aclandmark/FP_display_for_UNO_V2/Design_doc.odt

_display_2 timing

Clock for the one wire link.

Synchronise 9.6K data stream to 16MHz CPU frequency.

UNO (328) Use timer zero with times 8 prescaler giving a 2MHz clock.

Counts to 208.

ATtiny 1606 also offers a times 8 prescaler

Timing

Set WPU on com port

Set slow clock tick rate AND call Display_driver(0);

Tick 1 call Display_driver(1);

Tick 2 call Display_driver(2);

Tick 3 call Display_driver(3);

Tick 7 call Display_driver(7); AND set fast clock tick rate and issue start bit

Tick 8 send bit 0

Tick 9 send bit 1

Tick 15 send bit 7

Ticks 16 – 24 receive start bit and 8 data bits and wait 0.5 clock cycle then WPU

Repeat with slow clock tick AND Display_driver(0);

Display/comms timing

1606: 16MHz clock 8MHz prescaler gives 2MHz peripheral clock

In a 2mS display period it counts to 4000.

4800 417 2ms

For a 9600 baud rate it counts to 208 Transaction time is 1ms

19200 104 0.52

28800 69 0.35

38400 52 0.26

328: 16MHz clock Use x8 or x64 prescalers giving 2MHz or 0.25MHz clocks.

For a 4800 baud rate it counts to 417 or 52 (0.25MHz clock)

9600 208 or 26

Experimental set up:

328 has a 0.25MHz timer clock and counts to 20 giving a baud rate of 12.5K

1606 has a 0.25MHz timer clock and counts to 28 Experimental value; (0.35MHz clock 22.4MHz free running clock??)

1606 0.5 second period 2MHz Peripheral clock x64 prescaler gives 31.25KHz clock which counts to 15625 in 0.5 s

(Note counting to 21875 gives a 0.5 second period.

Prescaler clock is 43.75KHz rather than 31.25KHz

Peripheral clock is 2.8MHz rather than 2MHz.)

assumes a clock of 43.75Hz 22.4MHz)

9600 Baud rate 1606 has peripheral clock of 2.8MHz Count to 292 rather than 202
