aclandmark/FP_display_for_UNO_V2/Manufacturung_drawings/FP_display_V2.brd

## EAGLE design Manufacturung_drawings/FP_display_V2.brd (2022-12-22)

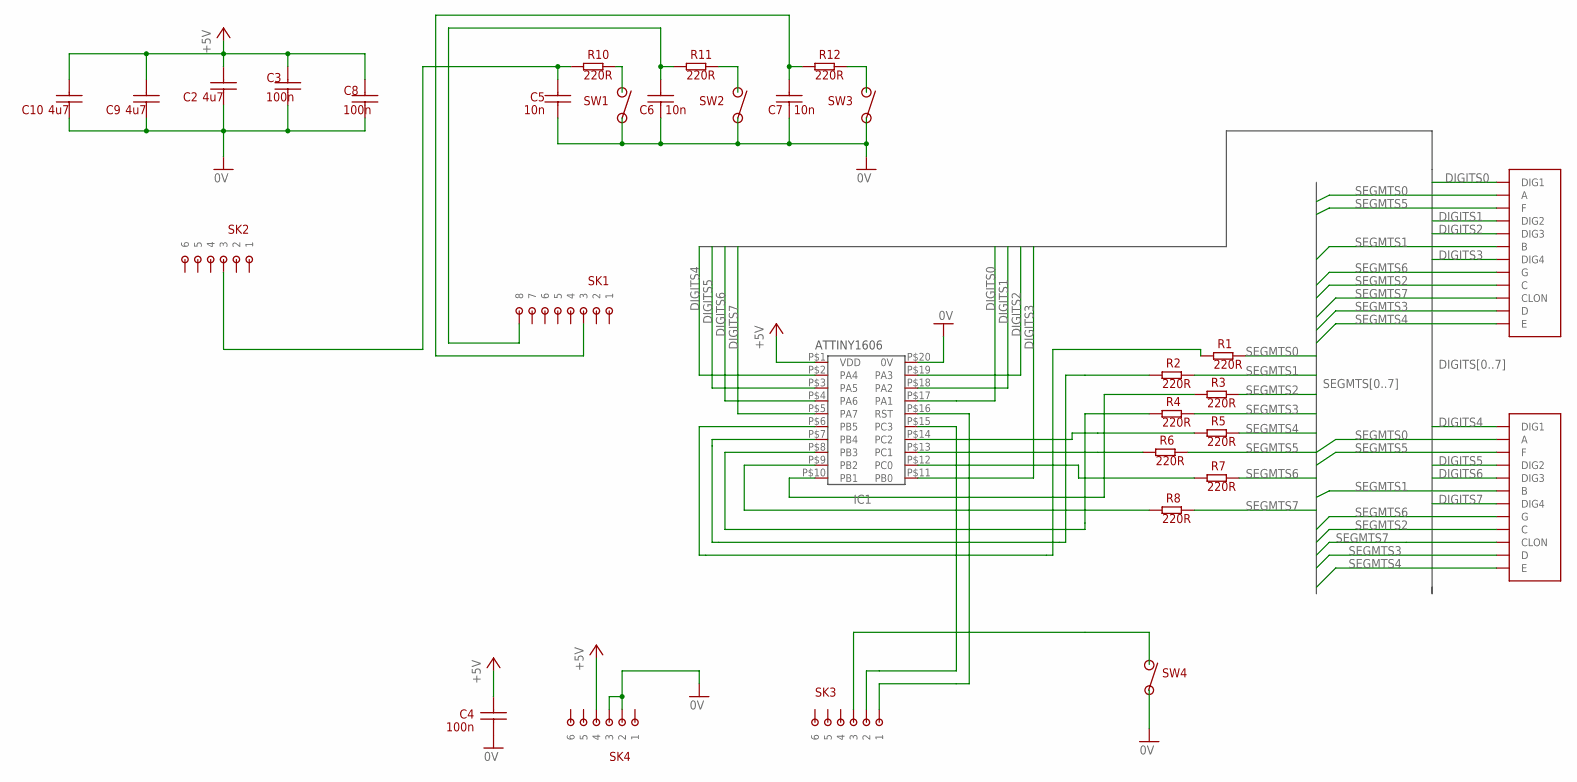
[picture p1: schematic FP_display_V2.sch]

Parts:
C2, C9, C10: 4u7; 1206
C3, C4, C8: 100n; 1206
C5, C6, C7: 10n; 1206
IC1: ATTINY1606
R1, R2, R3, R4, R5, R6, R7, R8, R10, R11, R12: 220R; 1206
SK1: 8_WAY_HEADER
SK2, SK3, SK4: 6_WAY_HEADER
SW1, SW2, SW3: BP_TH_NO; PB_NO_TH
SW4: PUSH_BUTTON_NO_SM
U$3, U$4: DISPLAY

Connections:
0V: C2.P$1, C3.P$1, C4.P$1, C5.P$1, C6.P$1, C7.P$1, C8.P$1, C9.P$1, C10.P$1, IC1.P$20 (0V), SK4.P$2 (2), SK4.P$3 (3), SW1.P$2, SW2.P$2, SW3.P$2, SW4.P$2
+5V: C2.P$2, C3.P$2, C4.P$2, C8.P$2, C9.P$2, C10.P$2, IC1.P$1 (VDD), SK4.P$4 (4)
DIGITS0: IC1.P$17 (PA1), U$3.P$12 (DIG1)
DIGITS1: IC1.P$18 (PA2), U$3.P$9 (DIG2)
DIGITS2: IC1.P$19 (PA3), U$3.P$8 (DIG3)
DIGITS3: IC1.P$11 (PB0), U$3.P$6 (DIG4)
DIGITS4: IC1.P$2 (PA4), U$4.P$12 (DIG1)
DIGITS5: IC1.P$3 (PA5), U$4.P$9 (DIG2)
DIGITS6: IC1.P$4 (PA6), U$4.P$8 (DIG3)
DIGITS7: IC1.P$5 (PA7), U$4.P$6 (DIG4)
unnamed: IC1.P$16 (RST), SK3.P$1 (1)
unnamed: IC1.P$6 (PB5), R1.P$1 (1)
unnamed: SK3.P$3 (3), SW4.P$1
unnamed: IC1.P$7 (PB4), R2.P$1 (1)
unnamed: IC1.P$15 (PC3), SK3.P$2 (2)
unnamed: IC1.P$12 (PC0), R7.P$1 (1)
unnamed: IC1.P$14 (PC2), R5.P$1 (1)
unnamed: IC1.P$13 (PC1), R6.P$1 (1)
unnamed: IC1.P$8 (PB3), R4.P$1 (1)
unnamed: IC1.P$10 (PB1), R3.P$1 (1)
unnamed: R10.P$2 (2), SW1.P$1
unnamed: R11.P$2 (2), SW2.P$1
unnamed: R12.P$2 (2), SW3.P$1
unnamed: C7.P$2, R12.P$1 (1), SK1.P$3 (3)
unnamed: C5.P$2, R10.P$1 (1), SK2.P$3 (3)
unnamed: C6.P$2, R11.P$1 (1), SK1.P$8 (8)
unnamed: IC1.P$9 (PB2), R8.P$1 (1)
SEGMTS0: R1.P$2 (2), U$3.P$11 (A), U$4.P$11 (A)
SEGMTS1: R2.P$2 (2), U$3.P$7 (B), U$4.P$7 (B)
SEGMTS2: R3.P$2 (2), U$3.P$4 (C), U$4.P$4 (C)
SEGMTS3: R4.P$2 (2), U$3.P$2 (D), U$4.P$2 (D)
SEGMTS4: R5.P$2 (2), U$3.P$1 (E), U$4.P$1 (E)
SEGMTS5: R6.P$2 (2), U$3.P$10 (F), U$4.P$10 (F)
SEGMTS6: R7.P$2 (2), U$3.P$5 (G), U$4.P$5 (G)
SEGMTS7: R8.P$2 (2), U$3.P$3 (CLON), U$4.P$3 (CLON)

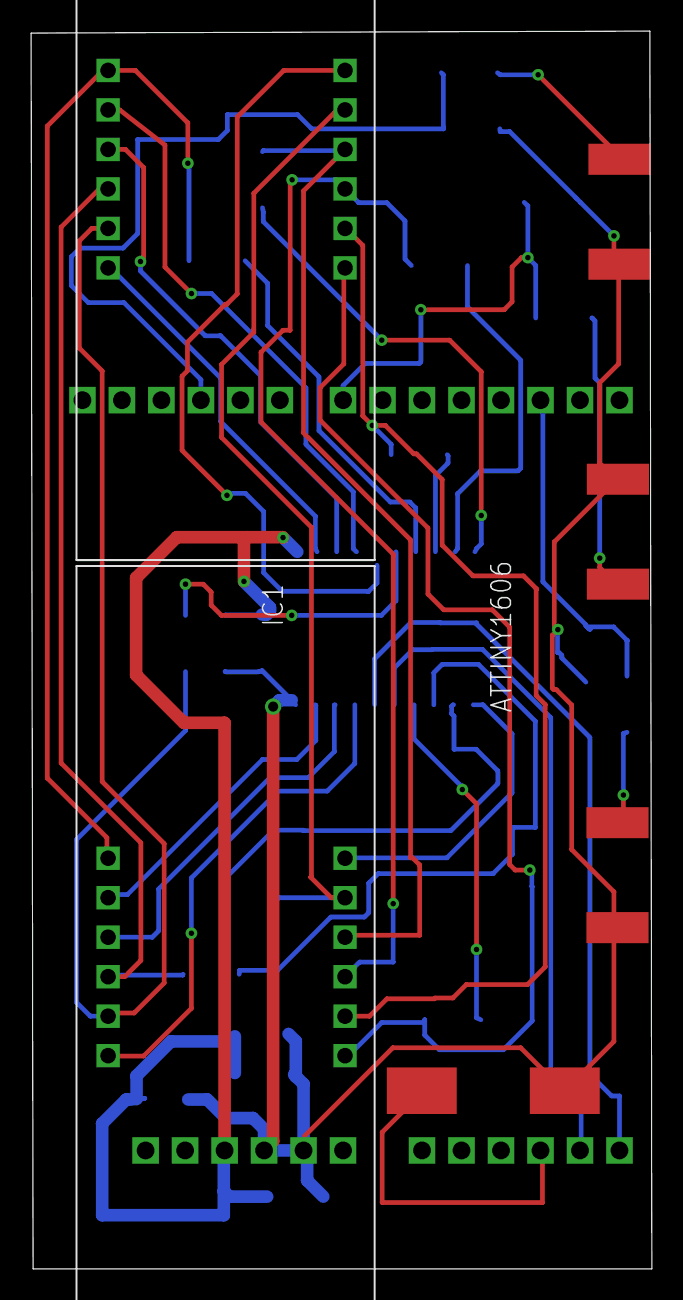
[picture p2: board FP_display_V2.brd from above]

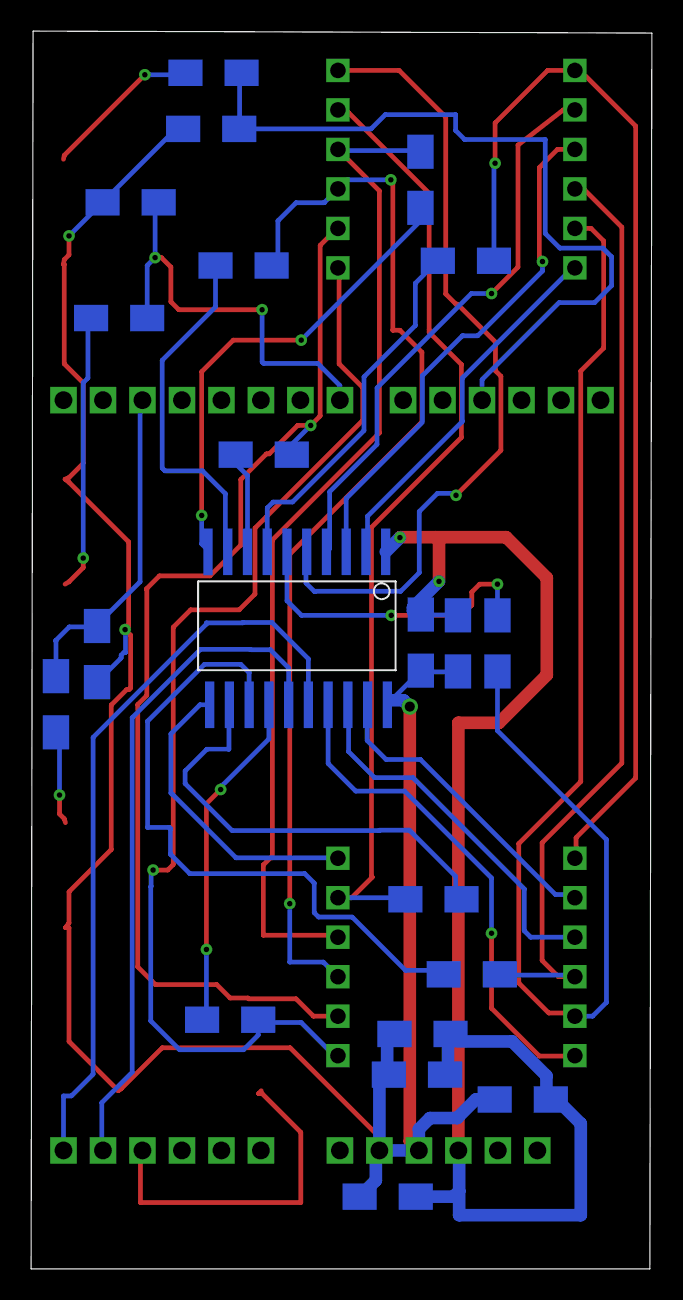
[picture p3: board FP_display_V2.brd from below]

Board: 2 copper layers, 39.9 x 79.6 mm, 31 parts (21 on the bottom side), 35 nets.
