aclandmark/FP_display_for_UNO_V2/Template_V9/Template_V9.ino

#include "Resources_Template_V9.h"                              //Contains resources used by template and shared with programmer
//#include "Resources_UPDI_programmer.h"                          //Only contains resources used by the programmer



/*
 * Programmer uses PC0 which is initialsed to Hi-Z input
 * Floating point display template uses PC4 for sinlge wire UART. It is also Hi-Z
 * All other ports are WPU
*/


int main (void){ 
  
char keypress;
long int_num;
float FPN;
char FP_string[12];


setup_328_HW;                                           //see "Resources\ATMEGA_Programmer


/************************Programmer code starts here and can be removed************************************
FlashSZ = 0x2000;                                      //Amount of flash availale in ATtiny 1606
User_prompt;

sendString("\r\nPress 'a' to program target or AOK to run taget code\r\n\r\n");
if(waitforkeypress() == 'a'){

//********************************Programmer target connection sequence************************************
Timer_T1_sub_with_interrupt(T1_delay_100ms);
sei();
contact_target;
configure_updi;                                       //Increases UPDI clock to 16MHz and reduce guard band to 2 cycles
print_out_SIB;
if(UPDI_timeout)
{sendString("Power Cycle Required\r\n");
while(1);}
else{cli();TCCR1B = 0;
TIMSK1 &= (~(1 << TOIE1));}

initialise_NVM_programming;
sendString("Programming fuses\r\n");
write_fuse (WDTCFG, 0x0);                             //Default value: WDT under program control
write_fuse (BODCFG,0x0);                              //Default value: BOD dissabled
write_fuse (OSCCFG, 0x01);                            //select the 16MHz internal clock with factory cal
write_fuse (SYSCFG0, 0xF7);                           //UPDI enabled, EEPROM preserved at chip erase
write_fuse (SYSCFG1, 0xFD);                           //16mS SUT
write_fuse (APPEND, 0);                               //No area of flash is partitioned off 
write_fuse (BOOTEND, 0);                              //for data or a bootloader


sendString("\r\nProgram flash with hex? -y- or AOK");
if (waitforkeypress() == 'y')
{ mode = 'H';                                         //Text mode is not included in this version of the programmer
sendString("\r\nSend file  ");
Program_Flash_Hex();}

Verify_Flash_Hex();
sendString("\r\nFuses:\tWDT, BOD, OSC,SYS0\tSYS1, APPEND, BOOTEND\r\n\t");
read_out_fuses();

UPDI_reset; 
Dissable_UPDI_sesion;}


//************Code for the UNO Floating point display is presented in the next section *************************
//**********************It is combined with the 1606 programmer for convenience**********************************
//*****************When development is complete the two applications can be separated***********************



sendString("\r\n\r\nRun trial application? -y- or AOK (POR may be required)\r\n\r\n");
if(waitforkeypress() == 'y'){

************************Programmmer code ends here*******************************************************************/


PCICR |= (1 << PCIE1); PCMSK1 |= (1 << PCINT11);                            //Set up PCI for SM switch
PORTC &= (~(1 << PORTC4));                                                  //One way comms for template requires port to be set to Tri state 
One_wire_Tx_char = 'F'; UART_Tx_1_wire();                                   //Command to reset 1606


while(1){

sei();                                                                      //Required to control intensity
  
User_prompt_template;

if (User_response =='i'){
sendString("Enter integer from KBD (terminate in cr)\r\n");

while (int_num = Int_from_KBD()){
sendString("AK to do arithmetic\r\n");
waitforkeypress();
Long_Num_to_UNO = Long_Num_from_UNO * 2;                                    //Simple arithmetic to check operation of binary/string conversions
send_int_num(Long_Num_to_UNO);
sendString("New number?\r\n");}}

if (User_response =='f'){
 sendString("Enter FPN from KBD (terminate in cr)\r\n"); 
 FPN =  Float_from_KBD();
 waitforkeypress();
 FPN = FPN * 2.75;                                                          //Simple arithmetic to check operation of binary/string conversions
send_float_num(FPN);}}

//}                                                                           //Only required if programmer code is included
/**********************************End to test code section*********************************************/
SW_reset;
return 1;}


 
