aclandmark/FP_display_for_UNO_V2/Template_V9/Resources_Template_V9.h

#include <avr/io.h>
#include <stdlib.h>
#include <avr/interrupt.h>
#include <avr/wdt.h>
#include <avr/eeprom.h>


#include "Resources_Template_V9\Resources_Template_V9.h"
#include "Resources_Template_V9\One_wire_transactions.c"
#include "Resources_Template_V9\ASKII_subroutines.c"
#include "Resources_Template_V9\Resources_shared.h"
#include "Resources_Template_V9\Resources_shared.c"
